Lobethal-Lutheran-School/LLS-Christmas-Light-Controller/(commit log)

2021-10-23 v1 Schematic
2021-10-23 Added stm32 arduino code to repository
2021-10-23 v1 Gerbers uploaded
2021-10-23 Add schematic to images folder
2021-10-23 Schematic added
    [LLS-christmas-lights-v1.sch]
2021-10-23 Add picture of assembled v1 board
2021-10-23 Add photograph of v1 board in action
2021-10-23 Add bill of materials
2021-10-24 Added pictures of v1 PCB
2021-10-24 Include PCB pictures in README
2021-10-31 Add pcb-rnd layout for v1
